DT-one/Generic-AD828-Audio-Amplifier-Board/ADA828_Amplifier.csv

Reference | Qty | Value | DNP | Exclude from BOM | Exclude from Board | Footprint | Datasheet
C1,C2,C4,C5 | 4 | 10u |  |  |  | Capacitor_SMD:CP_Elec_4x5.7 | ~
C3,C6 | 2 | 100u |  |  |  | Capacitor_SMD:CP_Elec_6.3x5.7 | ~
C7 | 1 | 1n |  |  |  | Capacitor_SMD:C_0603_1608Metric_Pad1.08x0.95mm_HandSolder | ~
H1,H2 | 2 | MountingHole_Pad |  | Excluded from BOM |  | FootPrintLibrary:TestPoint_Plated_Hole_D3.5mm | ~
J1,J2,J3,J4 | 4 | Conn_01x01_Socket |  | Excluded from BOM |  | TestPoint:TestPoint_THTPad_D2.0mm_Drill1.0mm | ~
J5 | 1 | + |  | Excluded from BOM |  | TestPoint:TestPoint_THTPad_D2.0mm_Drill1.0mm | ~
J6 | 1 | - |  | Excluded from BOM |  | TestPoint:TestPoint_THTPad_D2.0mm_Drill1.0mm | ~
J7,J10 | 2 | L |  | Excluded from BOM |  | TestPoint:TestPoint_THTPad_D2.0mm_Drill1.0mm | ~
J8,J11 | 2 | GND |  | Excluded from BOM |  | TestPoint:TestPoint_THTPad_D2.0mm_Drill1.0mm | ~
J9,J12 | 2 | R |  | Excluded from BOM |  | TestPoint:TestPoint_THTPad_D2.0mm_Drill1.0mm | ~
R1,R2 | 2 | 2.2k |  |  |  | Resistor_SMD:R_0603_1608Metric_Pad0.98x0.95mm_HandSolder | ~
R3,R4,R6,R8 | 4 | 10k |  |  |  | Resistor_SMD:R_0603_1608Metric_Pad0.98x0.95mm_HandSolder | ~
R5,R7 | 2 | 20k |  |  |  | Resistor_SMD:R_0603_1608Metric_Pad0.98x0.95mm_HandSolder | ~
U1 | 1 | AD828 |  |  |  | Package_SO:SOIC-8_3.9x4.9mm_P1.27mm | https://www.analog.com/media/en/technical-documentation/data-sheets/ad828.pdf
