DT-one/Generic-AD828-Audio-Amplifier-Board/ADA828_Amplifier.pdf

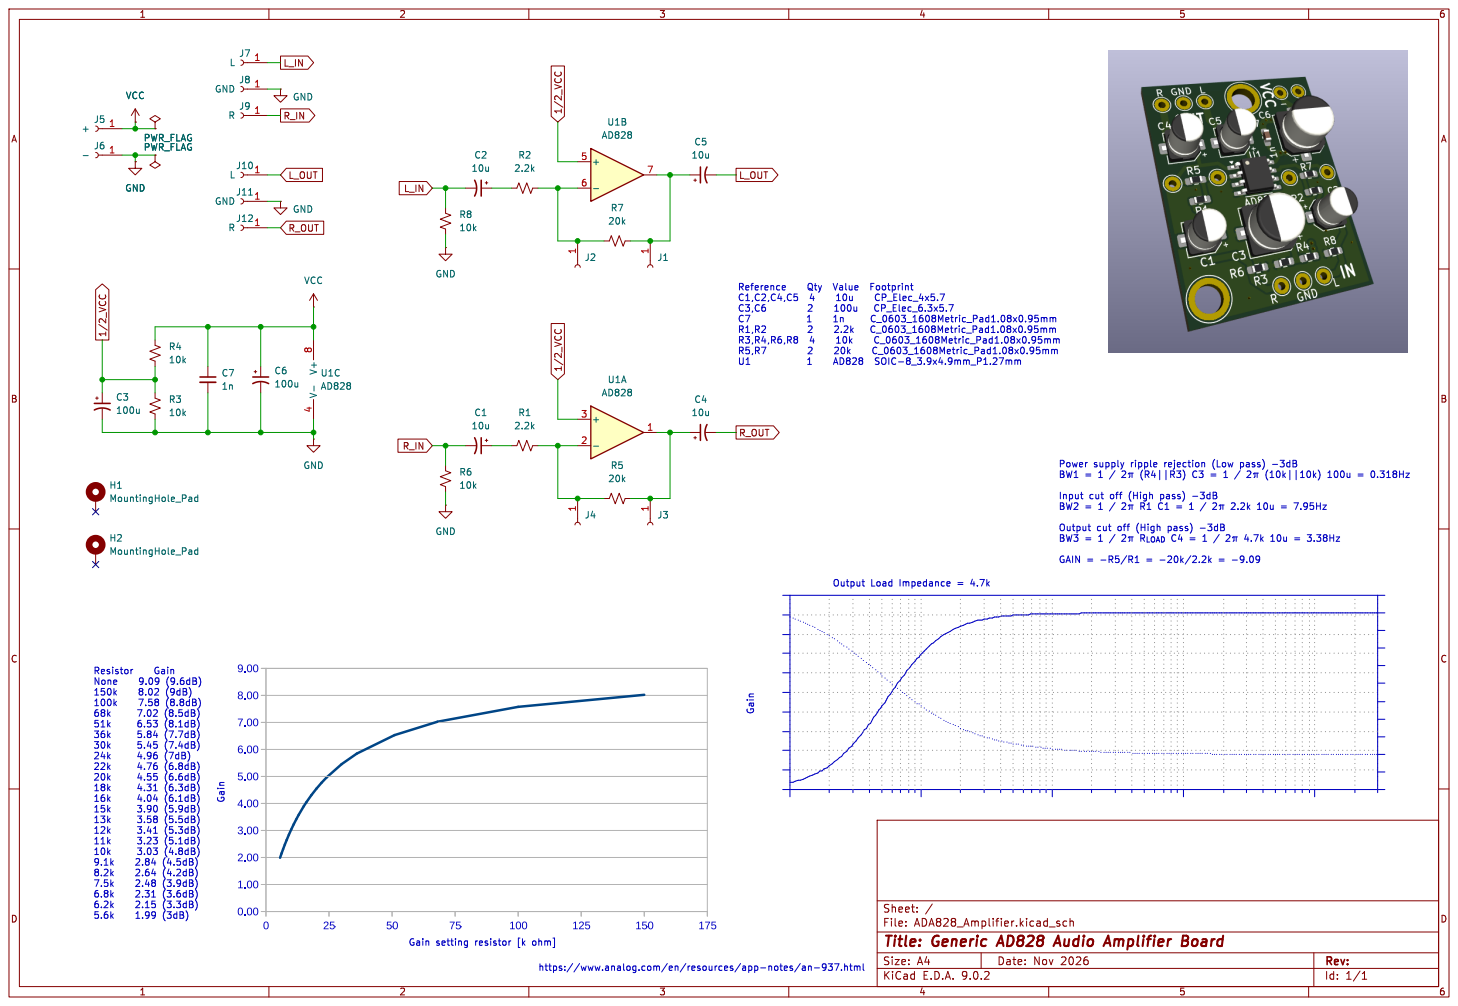
[picture p2: page 1]

Input cut off (High pass) -3dB
BW2 = 1 / þÿ2ÀR1 C1 = 1 / þÿ2À2.2k 10u = 7.95Hz Output cut off (High pass) -3dB

File: ADA828_Amplifier.kicad_sch Sheet: /
Id: 1/1 Title: Generic AD828 Audio Amplifier Board
