DT-one/Generic-AD828-Audio-Amplifier-Board/SpiceSim/Simulation_AudioPreamp.asc

C1: polcap; 10µ; V=16 Irms=2.12132 Rser=0.06 Lser=0 mfg="KEMET" pn="A700V106M016ATE060" type="Al electrolytic"
C2: polcap; 10µ; V=16 Irms=2.12132 Rser=0.06 Lser=0 mfg="KEMET" pn="A700V106M016ATE060" type="Al electrolytic"
C3: polcap; 100µ; V=16 Irms=265m Rser=0.35 Lser=0 mfg="Nichicon" pn="UPL1C101MPH" type="Al electrolytic"
C6: polcap; 100µ; V=16 Irms=265m Rser=0.35 Lser=0 mfg="Nichicon" pn="UPL1C101MPH" type="Al electrolytic"
C7: cap; 1n; V=50 Irms=0 Rser=0 Lser=0 mfg="Murata" pn="GRM1555C1H102JA01" type="C0G"
R1: res; 2.2k
R2: res; 10k
R3: res; 10k
R4: res; 10k
R5: res; 20k
R6: res; 1k
U1: opamp2; AD828
V1: voltage; 12; Rser=0.2
V2: voltage; ""; AC 1; Rser=1k
Named nets: 0, VCC, 1/2_VCC, R_IN, R_OUT
.lib ad828.cir
.ac dec 100 1 30e3
Load
Amplifier
Power Supply
Inputs
