DT-one/Generic-AD828-Audio-Amplifier-Board/ADA828_Amplifier.kicad_pcb

## KiCad design ADA828_Amplifier.kicad_pcb (2026-11-08)

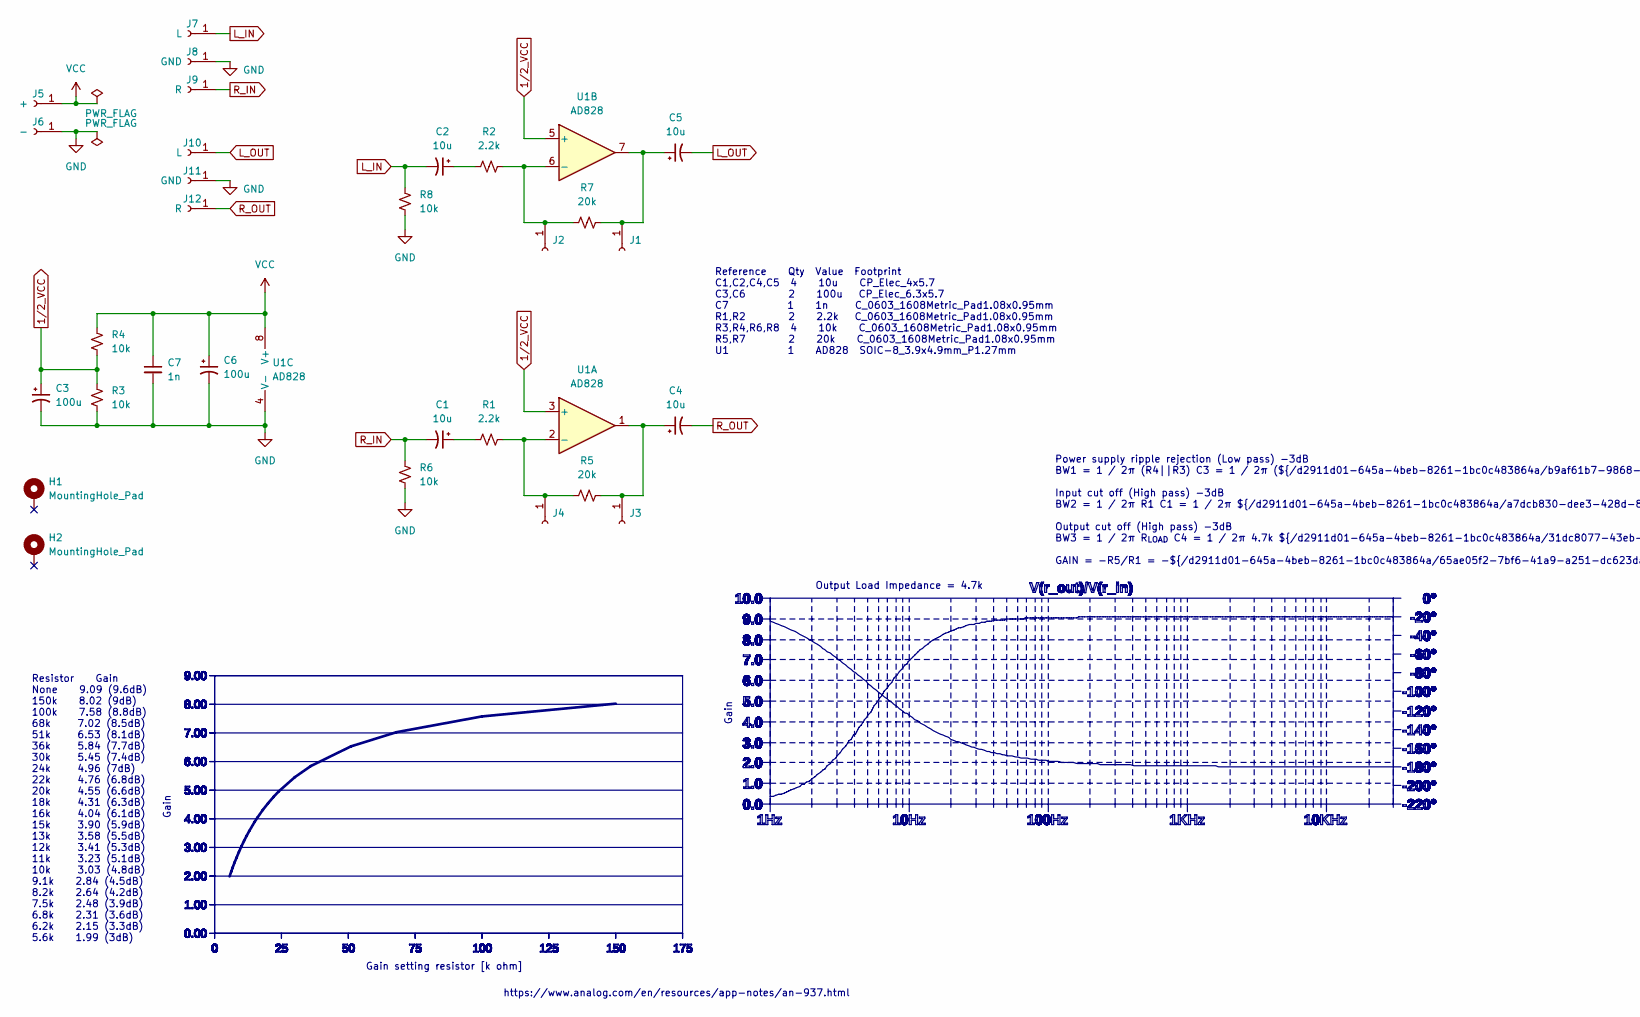
[picture p3: schematic ADA828_Amplifier.kicad_sch, Generic AD828 Audio Amplifier Board, part in row 1, column 1]

Parts:
C1, C2, C4, C5: 10u; CP_Elec_4x5.7
C3, C6: 100u; CP_Elec_6.3x5.7
C7: 1n; C_0603_1608Metric_Pad1.08x0.95mm_HandSolder
H1, H2: MountingHole_Pad; TestPoint_Plated_Hole_D3.5mm
J1, J2, J3, J4: Conn_01x01_Socket; TestPoint_THTPad_D2.0mm_Drill1.0mm
J5: +; TestPoint_THTPad_D2.0mm_Drill1.0mm
J6: -; TestPoint_THTPad_D2.0mm_Drill1.0mm
J7, J10: L; TestPoint_THTPad_D2.0mm_Drill1.0mm
J8, J11: GND; TestPoint_THTPad_D2.0mm_Drill1.0mm
J9, J12: R; TestPoint_THTPad_D2.0mm_Drill1.0mm
R1, R2: 2.2k; R_0603_1608Metric_Pad0.98x0.95mm_HandSolder
R3, R4, R6, R8: 10k; R_0603_1608Metric_Pad0.98x0.95mm_HandSolder
R5, R7: 20k; R_0603_1608Metric_Pad0.98x0.95mm_HandSolder
U1: AD828; SOIC-8_3.9x4.9mm_P1.27mm

Connections:
1/2_VCC: C3.1, R3.1, R4.2, U1.3 (+), U1.5 (+)
GND: C3.2, C6.2, C7.2, J6.1, J8.1, J11.1, R3.2, R6.2, R8.2, U1.4 (V-)
L_IN: C2.2, J7.1, R8.1
L_OUT: C5.2, J10.1
unnamed: C1.1, R1.2
unnamed: C2.1, R2.2
unnamed: C5.1, J1.1, R7.1, U1.7
unnamed: J2.1, R2.1, R7.2, U1.6 (-)
unnamed: C4.1, J3.1, R5.1, U1.1
unnamed: J4.1, R1.1, R5.2, U1.2 (-)
R_IN: C1.2, J9.1, R6.1
R_OUT: C4.2, J12.1
VCC: C6.1, C7.1, J5.1, R4.1, U1.8 (V+)

Notes on the sheet:
Power supply ripple rejection (Low pass) -3dB BW1 = 1 / 2π (R4||R3) C3 = 1 / 2π (${/d2911d01-645a-4beb-8261-1bc0c483864a/b9af61b7-9868-424c-a19b-94628b09d58a:value}||${/d2911d01-645a-4beb-8261-1bc0c483864a/655c2c68-45b3-4cb4-94c0-5e4d41aed458:value}) ${/d2911d01-645a-4beb-8261-1bc0c483864a/10caf2e7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
Output Load Impedance = 4.7k
Gain
Resistor Gain None 9.09 (9.6dB) 150k 8.02 (9dB) 100k 7.58 (8.8dB) 68k 7.02 (8.5dB) 51k 6.53 (8.1dB) 36k 5.84 (7.7dB) 30k 5.45 (7.4dB) 24k 4.96 (7dB) 22k 4.76 (6.8dB) 20k 4.55 (6.6dB) 18k 4.31 (6.3dB) 16k 4.04 (6.1dB) 15k 3.90 (5.9dB) 13k 3.58 (5.5dB) 12k 3.41 (5.3dB) 11k 3.23 (5.1dB) 10k 3.03 (4.8d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
https://www.analog.com/en/resources/app-notes/an-937.html
Reference Qty Value Footprint C1,C2,C4,C5 4 10u CP_Elec_4x5.7 C3,C6 2 100u CP_Elec_6.3x5.7 C7 1 1n C_0603_1608Metric_Pad1.08x0.95mm R1,R2 2 2.2k C_0603_1608Metric_Pad1.08x0.95mm R3,R4,R6,R8 4 10k C_0603_1608Metric_Pad1.08x0.95mm R5,R7 2 20k C_0603_1608Metric_Pad1.08x0.95mm U1 1 AD828 SOIC-8_3.9x4.9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
Gain setting resistor [k ohm]

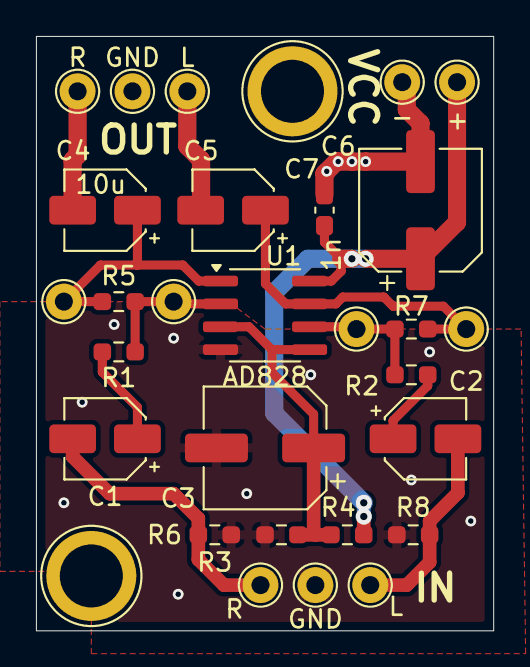
[picture p4: board ADA828_Amplifier.kicad_pcb from above]

Board: 2 copper layers, 25.4 x 33.0 mm, 30 parts (0 on the bottom side), 13 nets.
